About-Time-Technologies/MHCI/(threads)

Thread 1 (2025-05-09):

DMX Board is missing required RDM resistors.

minorDeveloper, 2025-05-09:
The two 510R pull up and pull down resistors are missing from the A and B lines of the DMX transmission traces.

Thread 2 (2025-05-09):

Logic level converter is unable to handle open drain (I2C) signals.

minorDeveloper, 2025-05-09:
We need to switch to a different logic level converter in order to ensure that I2C signals can be transmitted at 5v rather than just 3v3.
