About-Time-Technologies/MHCI/DMX/MHCI-DMX/MHCI-DMX.kicad_pcb

## KiCad design DMX/MHCI-DMX/MHCI-DMX.kicad_pcb (2025-08-21)

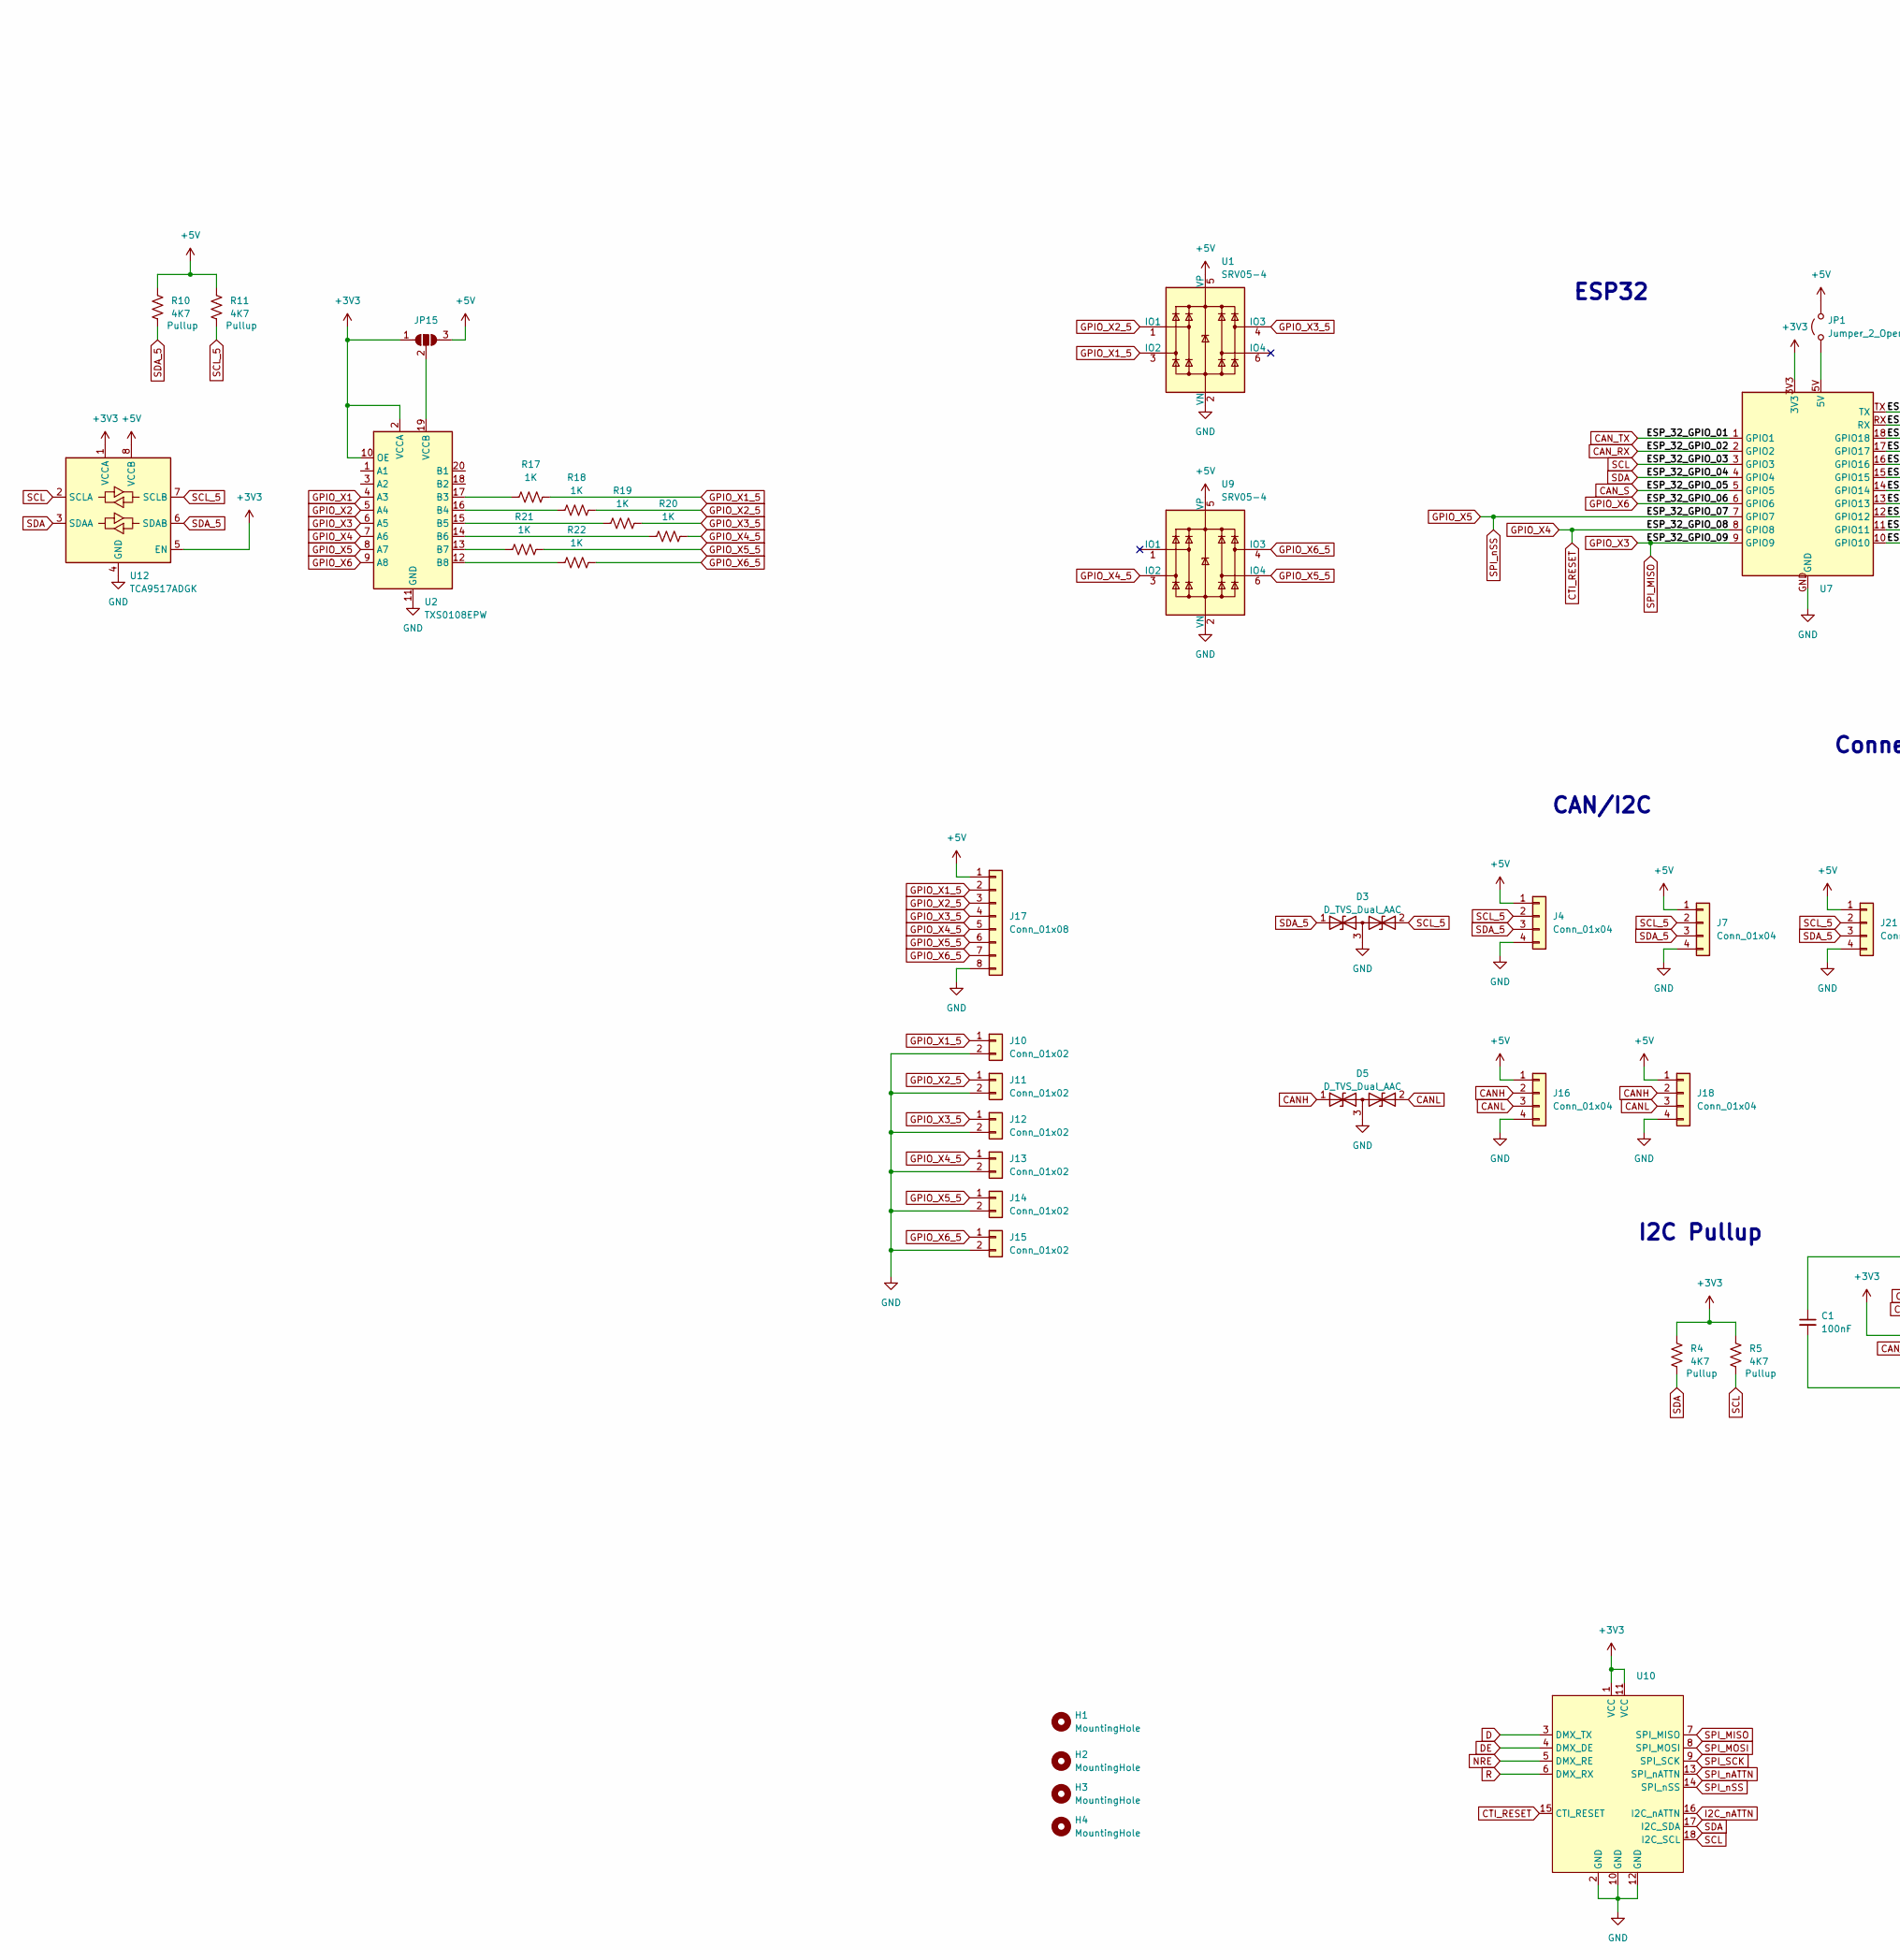
[picture p1: schematic MHCI-DMX.kicad_sch, part in row 1, column 1]

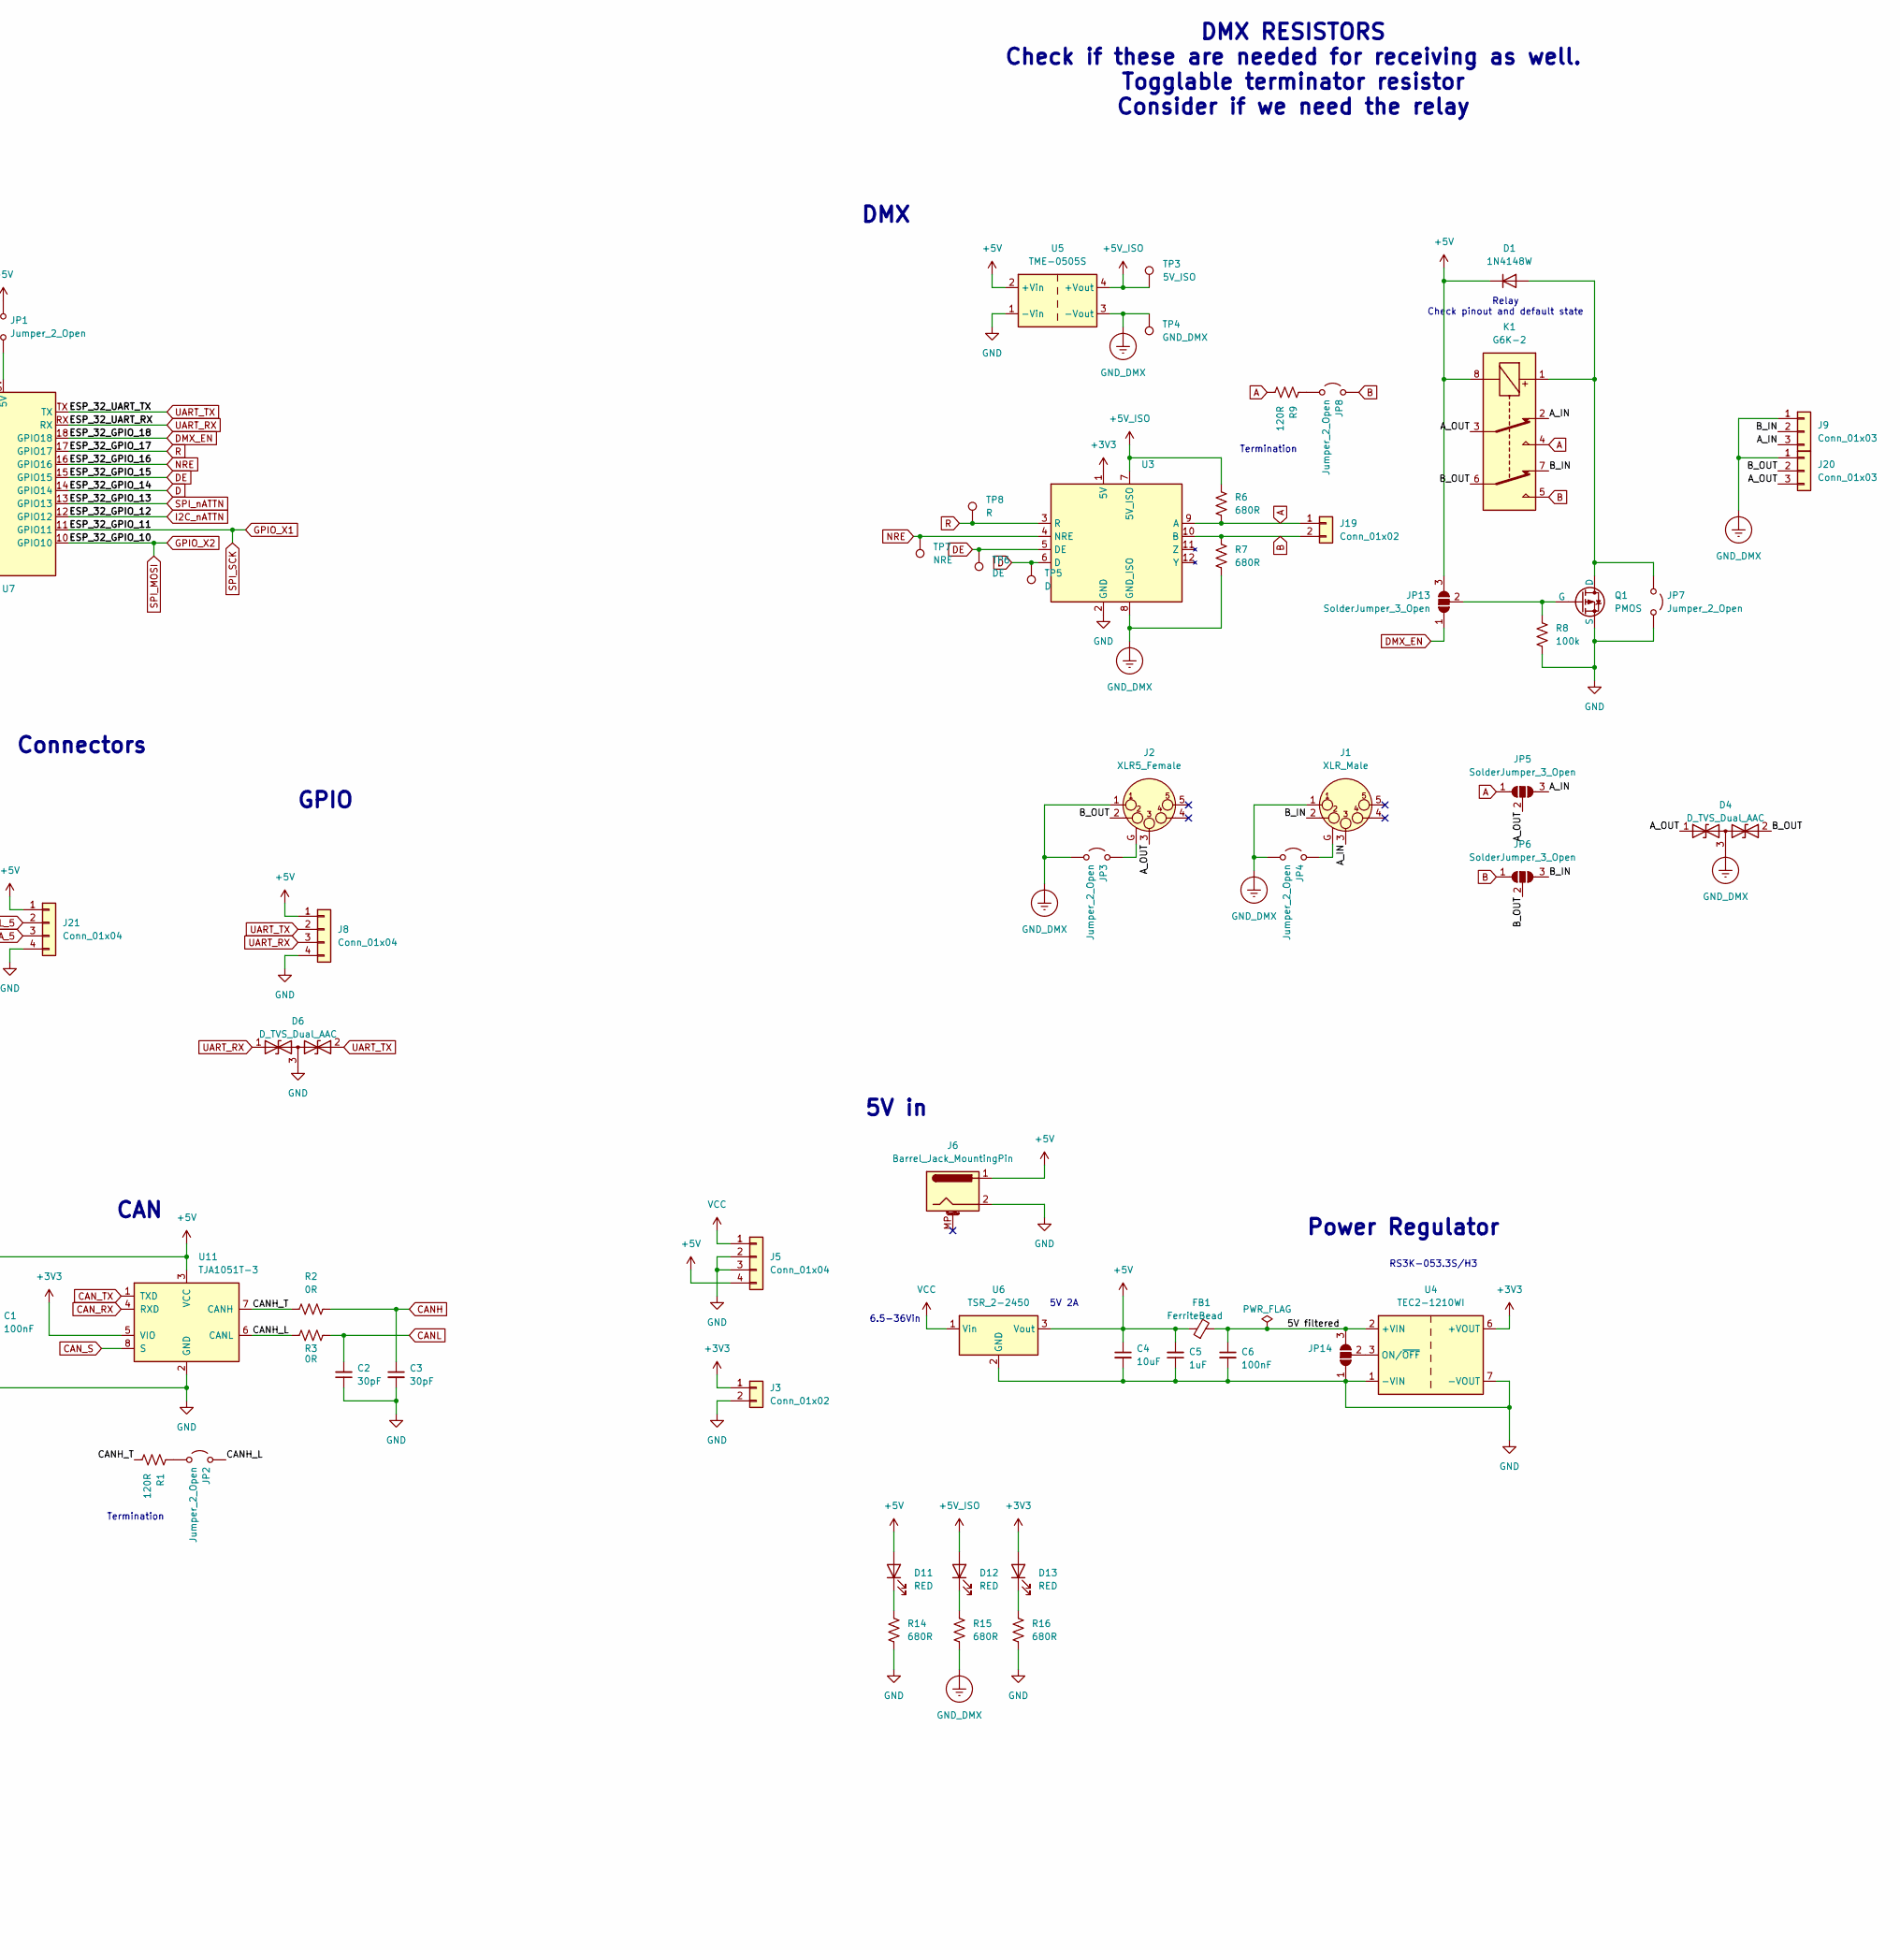
[picture p2: schematic MHCI-DMX.kicad_sch, part in row 1, column 2]

Parts:
C1, C6: 100nF; C_0402_1005Metric; LCSC C1525
C2, C3: 30pF; C_0402_1005Metric; LCSC C1570
C4: 10uF; C_0603_1608Metric; LCSC C96446
C5: 1uF; C_0402_1005Metric; LCSC C52923
D1: 1N4148W; D_SOD-123; LCSC C2099
D3, D4, D5, D6: D_TVS_Dual_AAC; SOT-23; LCSC C32677
D11, D12, D13: RED; LED_0603_1608Metric; LCSC C2286
FB1: FerriteBead; D_0805_2012Metric; LCSC C1015
H1, H2, H3, H4: MountingHole; MountingHole_3.2mm_M3
J1: XLR_Male; Jack_XLR_Neutrik_NC5MAH_LR
J2: XLR5_Female; Jack_XLR_Neutrik_NC5FAH_LR-DAE
J3, J19: Conn_01x02; PinHeader_1x02_P2.54mm_Vertical
J4, J7, J8, J16, J18: Conn_01x04; PinSocket_1x04_P2.54mm_Vertical
J5: Conn_01x04; PinHeader_1x04_P2.54mm_Vertical
J6: Barrel_Jack_MountingPin; BarrelJack_GCT_DCJ200-10-A_Horizontal
J9, J20: Conn_01x03; JST_XH_B3B-XH-AM_1x03_P2.50mm_Vertical
J10, J11, J12, J13, J14, J15: Conn_01x02; 2060-452-998-404 Wago
J17: Conn_01x08; PinSocket_1x08_P2.54mm_Vertical
J21: Conn_01x04; JST_XH_B4B-XH-AM_1x04_P2.50mm_Vertical
JP1, JP2, JP3, JP4, JP7, JP8: Jumper_2_Open; SolderJumper-2_P1.3mm_Open_RoundedPad1.0x1.5mm
JP5, JP6, JP13, JP14, JP15: SolderJumper_3_Open; SolderJumper-3_P1.3mm_Open_RoundedPad1.0x1.5mm
K1: G6K-2; Relay_DPDT_Omron_G6K-2F
Q1: PMOS; SOT-23; LCSC C10487
R1, R9: 120R; R_0402_1005Metric; LCSC C25079
R2, R3: 0R; R_0402_1005Metric; LCSC C17168
R4, R5, R10, R11: 4K7; R_0603_1608Metric; LCSC C23162
R6, R7: 680R; R_0402_1005Metric; LCSC C25130
R8: 100k; R_0603_1608Metric; LCSC C25803
R14, R15, R16: 680R; R_0603_1608Metric; LCSC C23228
R17, R18, R19, R20, R21, R22: 1K; R_0603_1608Metric; LCSC C21190
TP3: 5V_ISO; TestPoint_Pad_D1.0mm
TP4: GND_DMX; TestPoint_Pad_D1.0mm
TP5: D; TestPoint_Pad_D1.0mm
TP6: DE; TestPoint_Pad_D1.0mm
TP7: NRE; TestPoint_Pad_D1.0mm
TP8: R; TestPoint_Pad_D1.0mm
U1, U9: SRV05-4; SOT-23-6; LCSC C85364
U2: TXS0108EPW; TSSOP-20_4.4x6.5mm_P0.65mm; LCSC C17206
U3: ISO-DMX
U4: TEC2-1210WI; Converter_DCDC_TRACO_TMR-xxxx_THT
U5: TME-0505S; Converter_DCDC_TRACO_TME_03xxS_05xxS_12xxS_Single_THT
U6: TSR_2-2450; Converter_DCDC_TRACO_TSR-1_THT
U7: ESP-32-S3-Tiny - PTH
U10: WirelessDMX-Module
U11: TJA1051T-3; SOIC-8_3.9x4.9mm_P1.27mm; LCSC C5342108
U12: TCA9517ADGK; VSSOP-8_3x3mm_P0.65mm; LCSC C201698

Connections:
+3V3: D13.2 (A), J3.1, JP15.1 (A), R4.1, R5.1, U2.2 (VCCA), U2.10 (OE), U3.1 (5V), U4.6 (+VOUT), U7.3V3, U10.1 (VCC), U10.11 (VCC), U11.5 (VIO), U12.1 (VCCA), U12.5 (EN)
+5V: C1.1, C4.1, C5.2, D1.1 (K), D11.2 (A), FB1.1, J4.1, J5.4, J6.1, J7.1, J8.1, J16.1, J17.1, J18.1, J21.1, JP1.2 (B), JP13.3 (B), JP15.3 (B), K1.8, R10.1, R11.1, U1.5 (VP), U5.2 (+Vin), U6.3 (Vout), U9.5 (VP), U11.3 (VCC), U12.8 (VCCB)
+5V_ISO: D12.2 (A), R6.2, TP3.1, U3.7 (5V_ISO), U5.4 (+Vout)
/5V filtered: C6.1, FB1.2, JP14.3 (B), U4.2 (+VIN)
/A_IN: J1.3, J9.3, JP5.3 (B), K1.2
/A_OUT: D4.1 (A1), J2.3, J20.3, JP5.2 (C), K1.3
/B_IN: J1.2, J9.2, JP6.3 (B), K1.7
/B_OUT: D4.2 (A2), J2.2, J20.2, JP6.2 (C), K1.6
/CANH_L: JP2.2 (B), R3.1, U11.6 (CANL)
/CANH_T: R1.1, R2.2, U11.7 (CANH)
A: J19.1, JP5.1 (A), K1.4, R6.1, R9.1, U3.9 (A)
B: J19.2, JP6.1 (A), JP8.2 (B), K1.5, R7.2, U3.10 (B)
CANH: C3.1, D5.1 (A1), J16.2, J18.2, R2.1
CANL: C2.2, D5.2 (A2), J16.3, J18.3, R3.2
CAN_RX: U7.2 (GPIO2), U11.4 (RXD)
CAN_S: U7.5 (GPIO5), U11.8 (S)
CAN_TX: U7.1 (GPIO1), U11.1 (TXD)
CTI_RESET: U2.7 (A6), U7.8 (GPIO8), U10.15 (CTI_RESET)
D: TP5.1, U3.6 (D), U7.14 (GPIO14), U10.3 (DMX_TX)
DE: TP6.1, U3.5 (DE), U7.15 (GPIO15), U10.4 (DMX_DE)
DMX_EN: JP13.1 (A), U7.18 (GPIO18)
GND: C1.2, C2.1, C3.2, C4.2, C5.1, C6.2, D3.3 (common), D5.3 (common), D6.3 (common), J3.2, J4.4, J5.2, J5.3, J6.2, J7.4, J8.4, J10.2, J11.2, J12.2, J13.2, J14.2, J15.2, J16.4, J17.8, J18.4, J21.4, JP7.2 (B), JP14.1 (A), Q1.2 (S), R8.2, R14.2, R16.2, U1.2 (VN), U2.11 (GND), U3.2 (GND), U4.1 (-VIN), U4.7 (-VOUT), U5.1 (-Vin), U6.2 (GND), U7.GND, U9.2 (VN), U10.2 (GND), U10.10 (GND), U10.12 (GND), U11.2 (GND), U12.4 (GND)
GND_DMX: D4.3 (common), J1.1, J2.1, J9.1, J20.1, JP3.1 (A), JP4.1 (A), R7.1, R15.2, TP4.1, U3.8 (GND_ISO), U5.3 (-Vout)
GPIO_X1: U2.4 (A3), U7.11 (GPIO11), U10.9 (SPI_SCK)
GPIO_X1_5: J10.1, J17.2, R17.2, U1.3 (IO2)
GPIO_X2: U2.5 (A4), U7.10 (GPIO10), U10.8 (SPI_MOSI)
GPIO_X2_5: J11.1, J17.3, R18.2, U1.1 (IO1)
GPIO_X3: U2.6 (A5), U7.9 (GPIO9), U10.7 (SPI_MISO)
GPIO_X3_5: J12.1, J17.4, R19.2, U1.4 (IO3)
GPIO_X4_5: J13.1, J17.5, R20.2, U9.3 (IO2)
GPIO_X5: U2.8 (A7), U7.7 (GPIO7), U10.14 (SPI_nSS)
GPIO_X5_5: J14.1, J17.6, R21.2, U9.6 (IO4)
GPIO_X6: U2.9 (A8), U7.6 (GPIO6)
GPIO_X6_5: J15.1, J17.7, R22.2, U9.4 (IO3)
I2C_nATTN: U7.12 (GPIO12), U10.16 (I2C_nATTN)
NRE: TP7.1, U3.4 (NRE), U7.16 (GPIO16), U10.5 (DMX_RE)
unnamed: D1.2 (A), JP7.1 (A), K1.1, Q1.3 (D)
unnamed: D11.1 (K), R14.1
unnamed: D12.1 (K), R15.1
unnamed: D13.1 (K), R16.1
unnamed: JP1.1 (A), U7.5V
unnamed: JP2.1 (A), R1.2
unnamed: J2.G, JP3.2 (B)
unnamed: J1.G, JP4.2 (B)
unnamed: JP8.1 (A), R9.2
unnamed: JP13.2 (C), Q1.1 (G), R8.1
unnamed: JP14.2 (C), U4.3 (ON/~OFF)
unnamed: JP15.2 (C), U2.19 (VCCB)
unnamed: R17.1, U2.17 (B3)
unnamed: R18.1, U2.16 (B4)
unnamed: R19.1, U2.15 (B5)
unnamed: R20.1, U2.14 (B6)
unnamed: R21.1, U2.13 (B7)
unnamed: R22.1, U2.12 (B8)
R: TP8.1, U3.3 (R), U7.17 (GPIO17), U10.6 (DMX_RX)
SCL: R5.2, U7.3 (GPIO3), U10.18 (I2C_SCL), U12.2 (SCLA)
SCL_5: D3.2 (A2), J4.2, J7.2, J21.2, R11.2, U12.7 (SCLB)
SDA: R4.2, U7.4 (GPIO4), U10.17 (I2C_SDA), U12.3 (SDAA)
SDA_5: D3.1 (A1), J4.3, J7.3, J21.3, R10.2, U12.6 (SDAB)
SPI_nATTN: U7.13 (GPIO13), U10.13 (SPI_nATTN)
UART_RX: D6.1 (A1), J8.3, U7.RX
UART_TX: D6.2 (A2), J8.2, U7.TX
VCC: J5.1, U6.1 (Vin)

Notes on the sheet:
Connectors
5V 2A
CAN
DMX
Termination
RS3K-053.3S/H3
5V in
Relay Check pinout and default state
ESP32
CAN/I2C
I2C Pullup
DMX RESISTORS Check if these are needed for receiving as well. Togglable terminator resistor Consider if we need the relay
GPIO
Power Regulator
6.5-36Vin

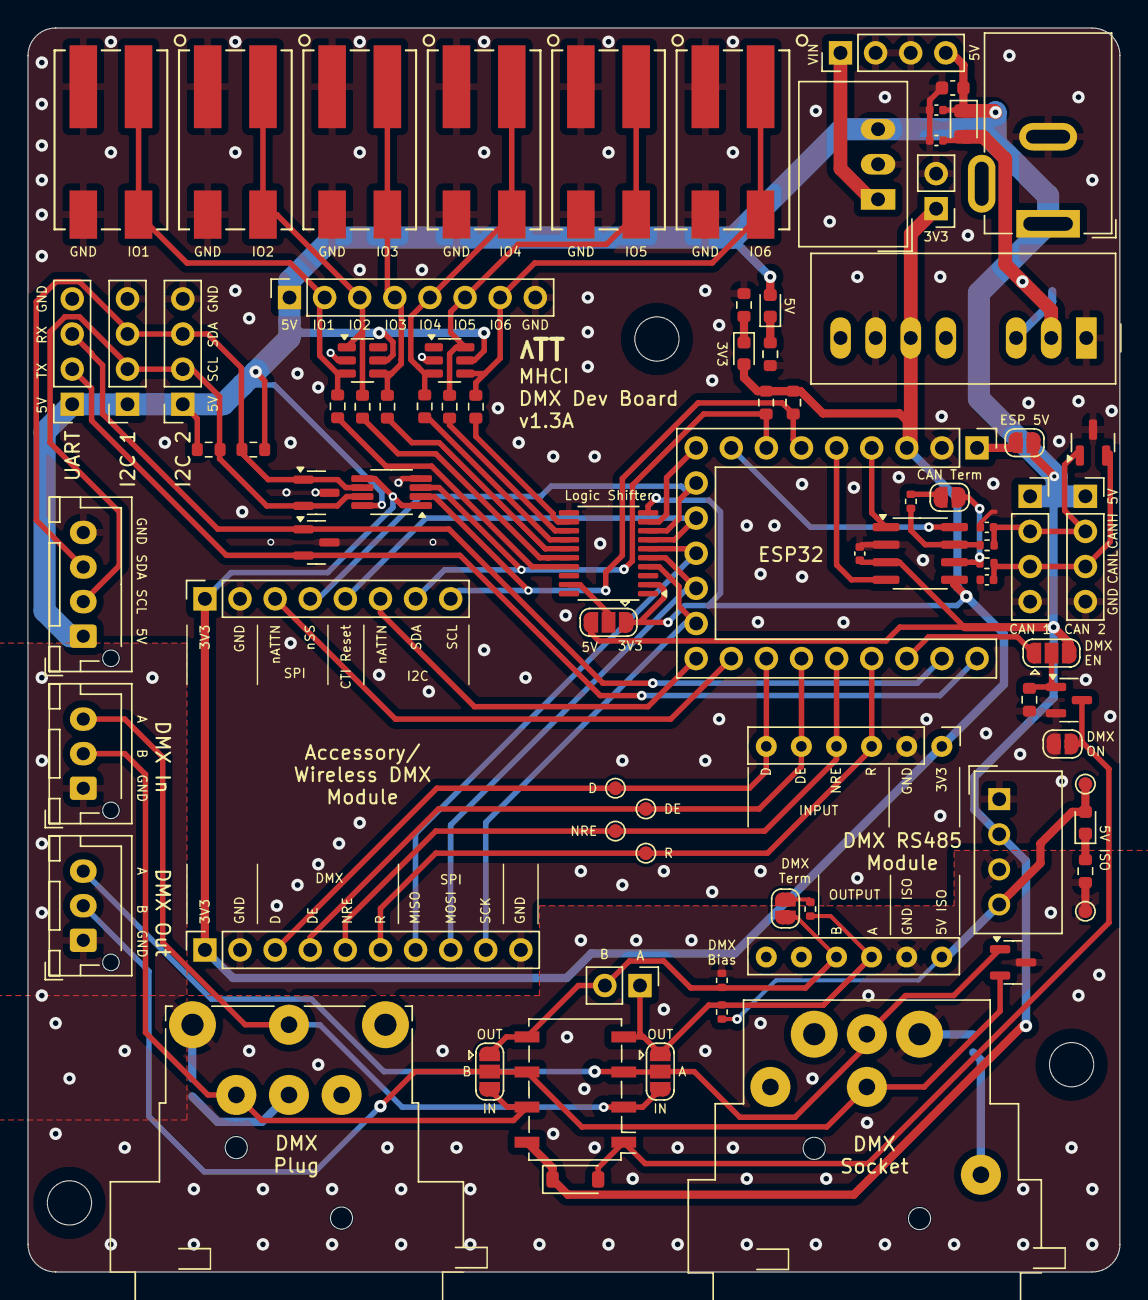
[picture p3: board MHCI-DMX.kicad_pcb from above]

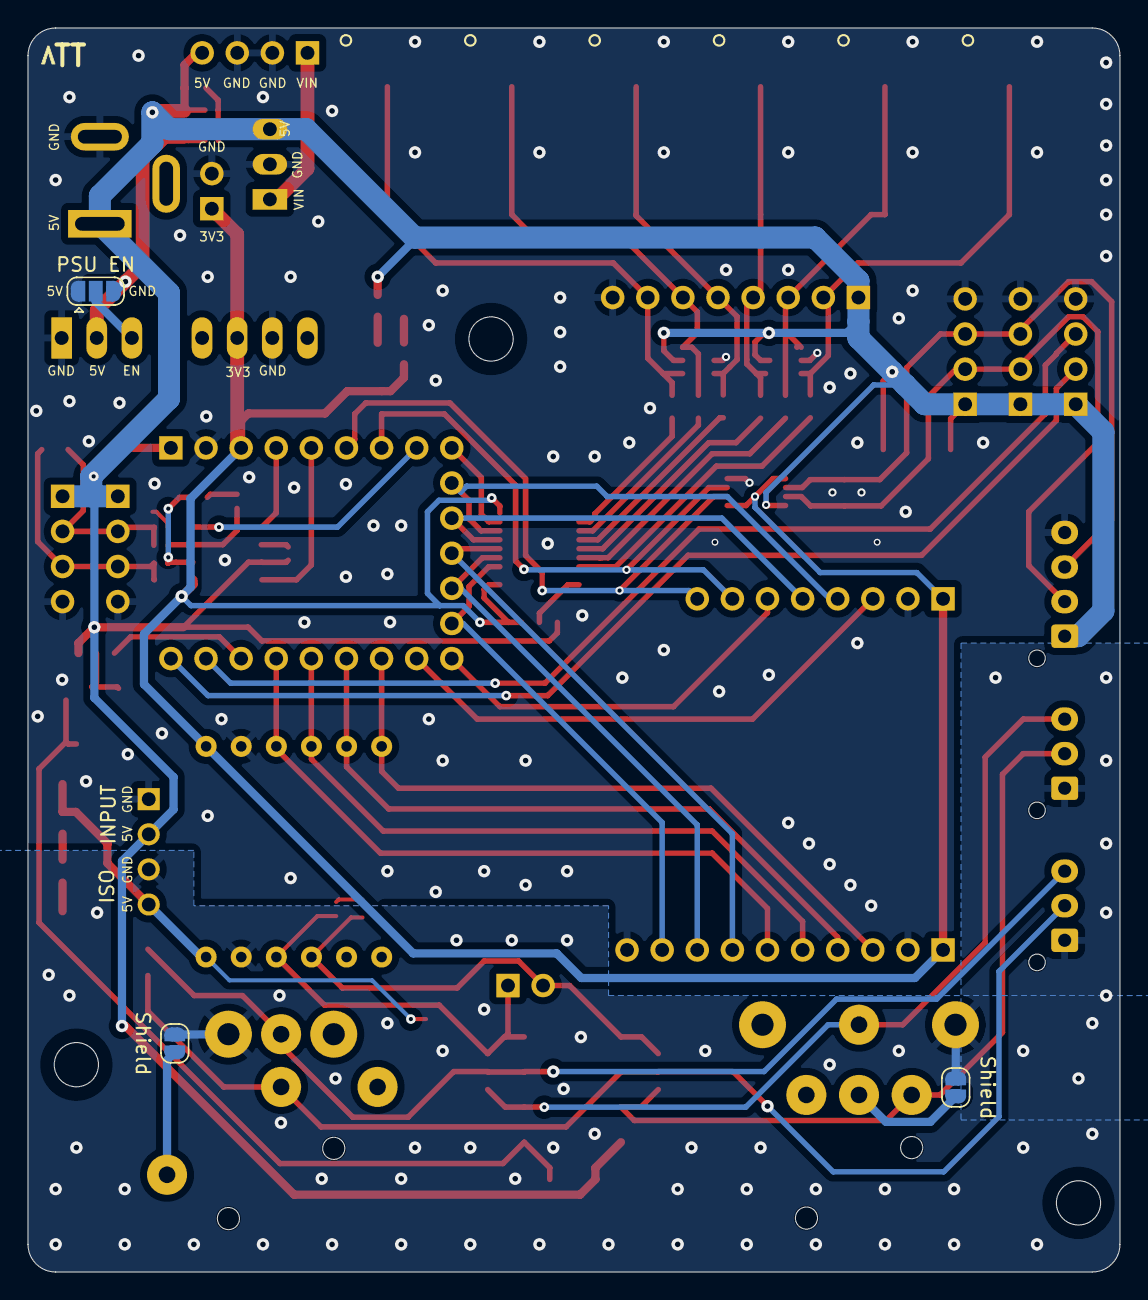
[picture p4: board MHCI-DMX.kicad_pcb from below]

Board: 2 copper layers, 79.0 x 90.0 mm, 89 parts (3 on the bottom side), 63 nets.
