About-Time-Technologies/MHCI/(commit log)

2025-07-24 Adding 680R bias resistor network
    [MHCI-DMX.kicad_pcb, MHCI-DMX.kicad_sch]
2025-08-21 New screen
    [MHCI-DMX.kicad_pcb, MHCI-DMX.kicad_sch]
2025-09-03 Virtual button state machine
2025-09-04 Encoder transition
2025-09-04 Prototype LED control
2025-09-04 Fix PWM GPIO values
    [atmecontroller.cpp, atmecontroller.hpp, atmedmx.cpp, main.cpp]
2025-09-04 Fix casting of address to uint8_t
    [atmecontroller.cpp]
2025-09-04 Adjusting UI alignment and LED label
